essensys-hub/essensys-i2c-ba-sniffer/hardware/fritzing/export/sonde-i2c-passive-ensemble_breadboard.png

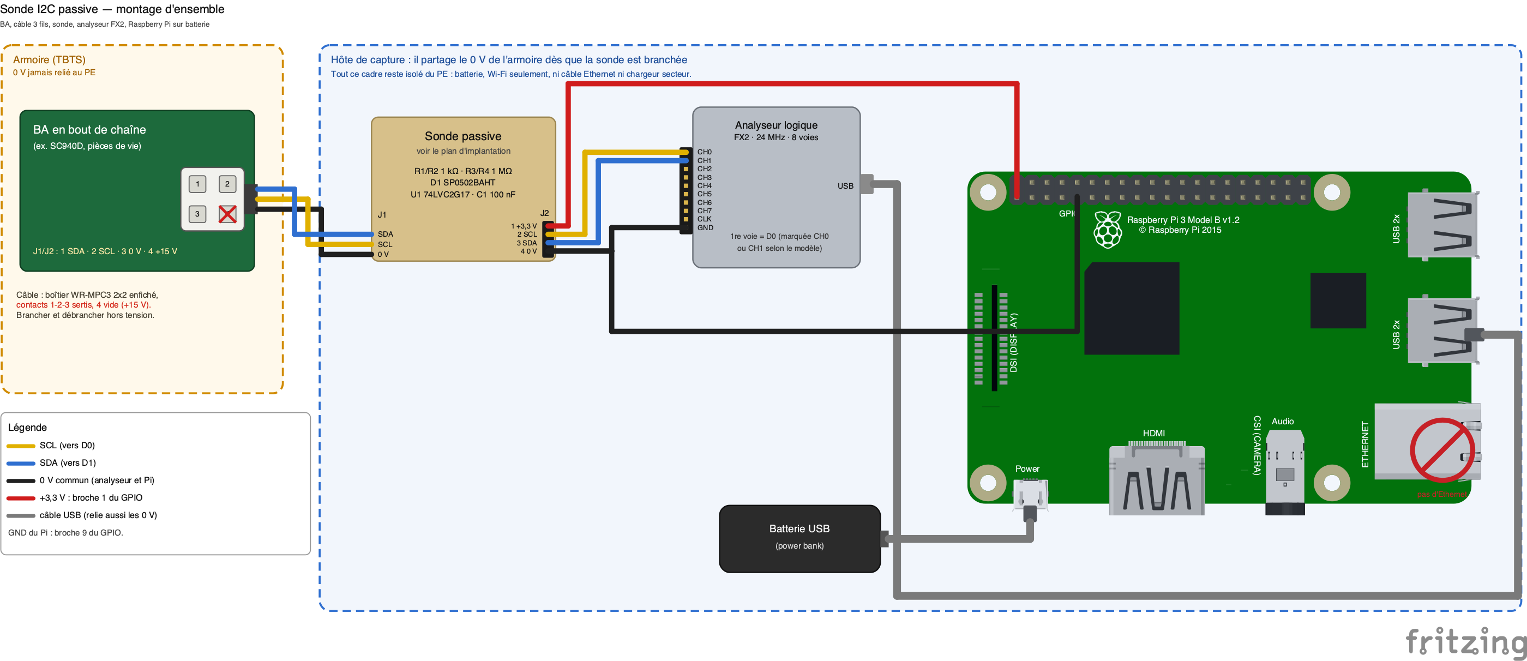
hardware/fritzing/export/sonde-i2c-passive-ensemble_breadboard.png
