essensys-hub/essensys-i2c-ba-sniffer/hardware/kicad/export/sonde-i2c-passive.png

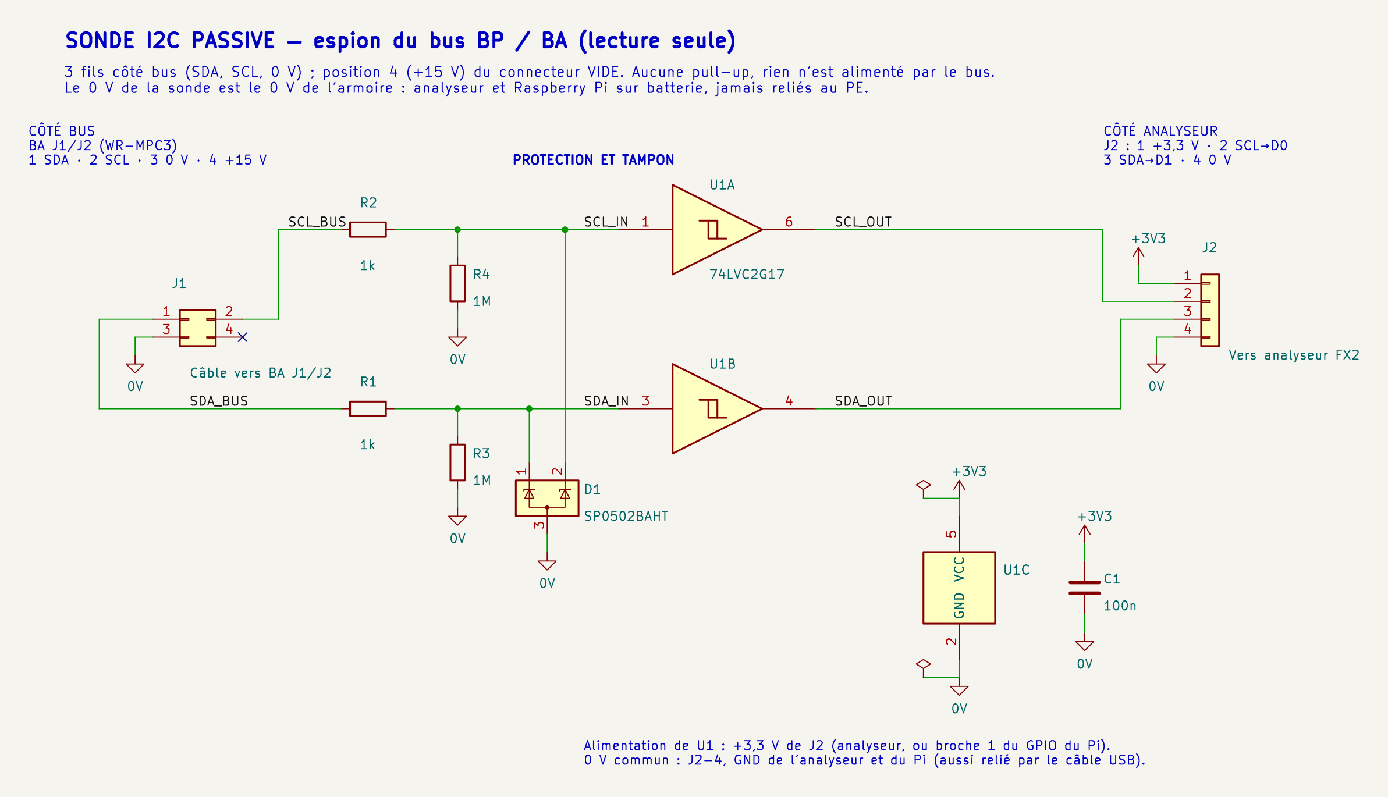
hardware/kicad/export/sonde-i2c-passive.png
