essensys-hub/essensys-i2c-ba-sniffer/hardware/kicad/export/sonde-i2c-passive-bom.csv

Repère | Valeur | Empreinte | Fabricant | Référence | Note | Qté
C1 | 100n | Capacitor_THT:C_Disc_D5.0mm_W2.5mm_P5.00mm |  |  | Découplage au plus près de U1 | 1
D1 | SP0502BAHT | Package_TO_SOT_SMD:SOT-23 | Littelfuse | SP0502BAHT | Sur adaptateur SOT-23 vers SIP3 | 1
J1 | Câble vers BA J1/J2 |  | Würth Elektronik | WR-MPC3 2x2, boîtier femelle câble (à confirmer, tâche 5.1) | Boîtier câble ; seuls les contacts 1, 2, 3 sont sertis, la position 4 (+15 V) reste vide ; fils soudés sur la plaque | 1
J2 | Vers analyseur FX2 | Connector_PinHeader_2.54mm:PinHeader_1x04_P2.54mm_Vertical |  |  | 1 +3,3 V, 2 SCL vers D0, 3 SDA vers D1, 4 0 V (GND de l'analyseur et du Pi) | 1
R1,R2 | 1k | Resistor_THT:R_Axial_DIN0207_L6.3mm_D2.5mm_P7.62mm_Horizontal |  |  | Série SCL,Série SDA | 2
R3,R4 | 1M | Resistor_THT:R_Axial_DIN0207_L6.3mm_D2.5mm_P7.62mm_Horizontal |  |  | Rappel SCL au 0 V,Rappel SDA au 0 V | 2
U1 | 74LVC2G17 | Package_TO_SOT_SMD:SOT-363_SC-70-6 | Nexperia / TI | 74LVC2G17GW / SN74LVC2G17DCK | Entrées tolérantes 5,5 V (Ioff) sous VCC = 3,3 V ; sur adaptateur SC-70 vers DIP6 | 1
