essensys-hub/essensys-i2c-ba-sniffer/hardware/mecanique/boitier-j1-wr-mpc3-assemblage.step

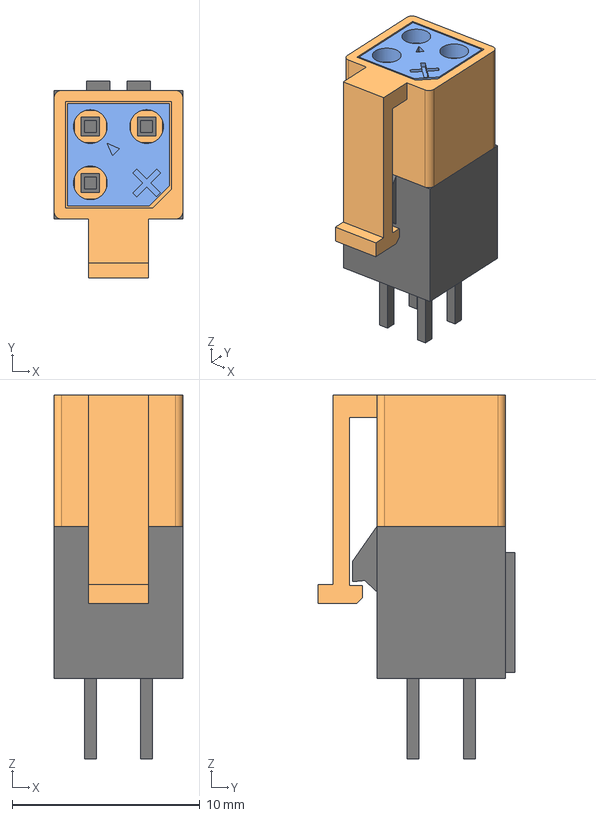
[picture p5: CAD file, 2026-10-14]
hardware/mecanique/boitier-j1-wr-mpc3-assemblage.step
6.86 x 10.5 x 19.4 mm
embase-BA-simplifiee
boitier
capot
