essensys-hub/essensys-i2c-ba-sniffer/hardware/mecanique/boitier-j1-wr-mpc3.step

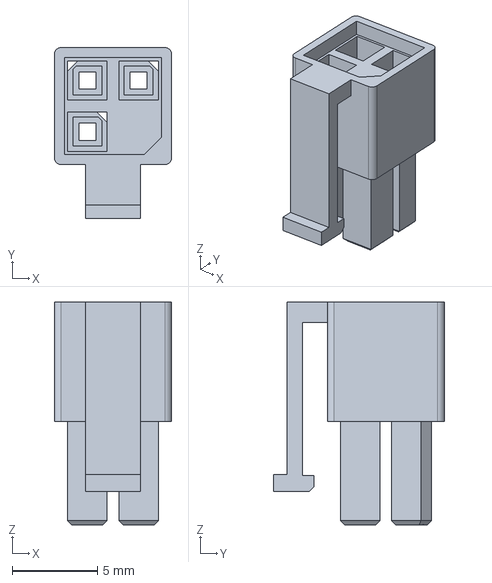
[picture p6: CAD file, 2026-10-14]
hardware/mecanique/boitier-j1-wr-mpc3.step
6.86 x 10.0 x 13.1 mm
