essensys-hub/essensys-i2c-ba-sniffer/hardware/mecanique/boitier-j1-wr-mpc3-capot.step

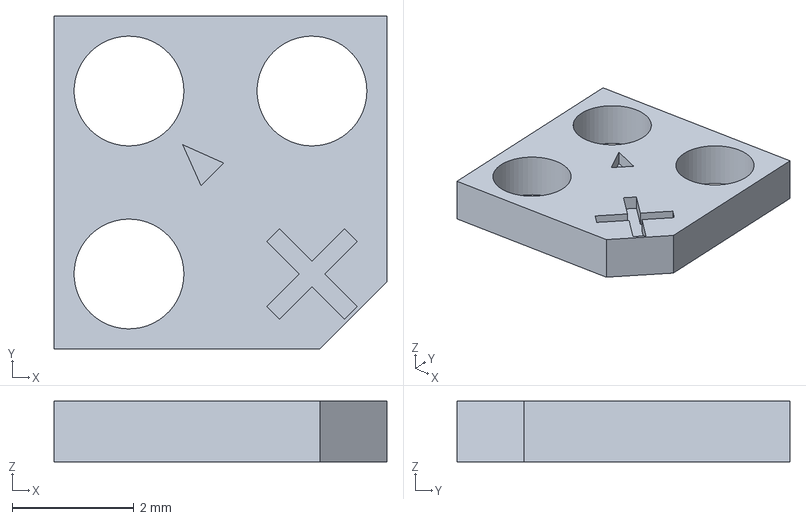
[picture p7: CAD file, 2026-10-14]
hardware/mecanique/boitier-j1-wr-mpc3-capot.step
5.46 x 5.46 x 1.00 mm
