essensys-hub/essensys-i2c-ba-sniffer/hardware/mecanique/calibre-contacts.step

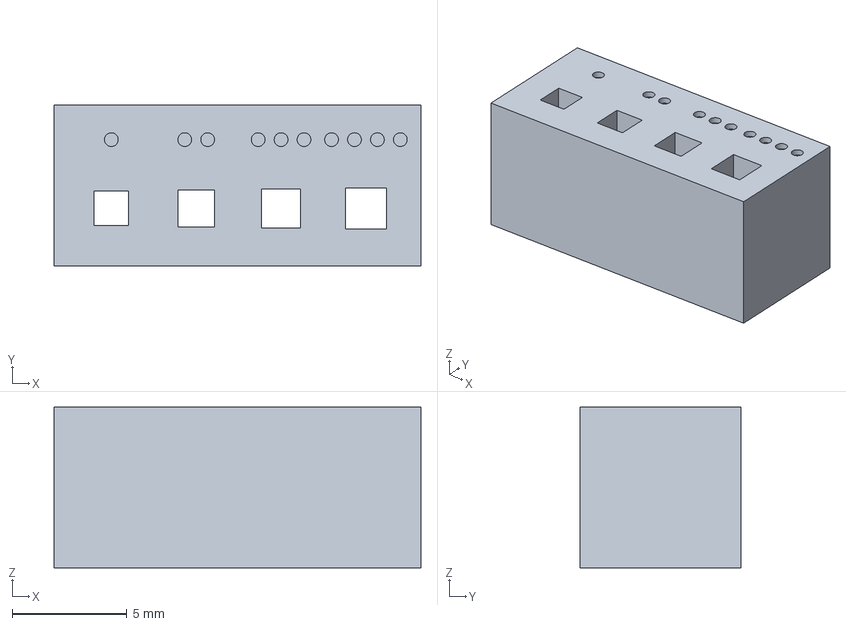
[picture p8: CAD file, 2026-10-14]
hardware/mecanique/calibre-contacts.step
16.0 x 7.00 x 7.00 mm
