essensys-hub/essensys-i2c-ba-sniffer/captures/corpus/cas_installation_2026_10.ann.txt

1005-1005 i2c-1: Start
1160-1180 i2c-1: Write
1020-1160 i2c-1: Address write: 11
1180-1200 i2c-1: ACK
1200-1360 i2c-1: Data write: 01
1360-1380 i2c-1: ACK
1380-1540 i2c-1: Data write: 00
1540-1560 i2c-1: ACK
1560-1720 i2c-1: Data write: 01
1720-1740 i2c-1: ACK
1740-1900 i2c-1: Data write: 00
1900-1920 i2c-1: ACK
1920-2080 i2c-1: Data write: 00
2080-2100 i2c-1: ACK
2100-2260 i2c-1: Data write: 00
2260-2280 i2c-1: ACK
2280-2440 i2c-1: Data write: 00
2440-2460 i2c-1: ACK
2460-2620 i2c-1: Data write: 00
2620-2640 i2c-1: ACK
2640-2800 i2c-1: Data write: 00
2800-2820 i2c-1: ACK
2820-2980 i2c-1: Data write: 17
2980-3000 i2c-1: ACK
3000-3160 i2c-1: Data write: A0
3160-3180 i2c-1: ACK
3185-3185 i2c-1: Start repeat
3340-3360 i2c-1: Read
3200-3340 i2c-1: Address read: 11
3360-3380 i2c-1: ACK
3380-3540 i2c-1: Data read: 01
3540-3560 i2c-1: ACK
3560-3720 i2c-1: Data read: 17
3720-3740 i2c-1: ACK
3740-3900 i2c-1: Data read: A0
3900-3920 i2c-1: ACK
3920-4080 i2c-1: Data read: 2F
4080-4100 i2c-1: ACK
4100-4260 i2c-1: Data read: 88
4260-4280 i2c-1: NACK
4285-4285 i2c-1: Stop
104295-104295 i2c-1: Start
104450-104470 i2c-1: Write
104310-104450 i2c-1: Address write: 12
104470-104490 i2c-1: NACK
104495-104495 i2c-1: Stop
204505-204505 i2c-1: Start
204660-204680 i2c-1: Write
204520-204660 i2c-1: Address write: 13
204680-204700 i2c-1: NACK
204705-204705 i2c-1: Stop
