essensys-hub/essensys-i2c-ba-sniffer/hardware/kicad/export/sonde-i2c-passive-schema.pdf

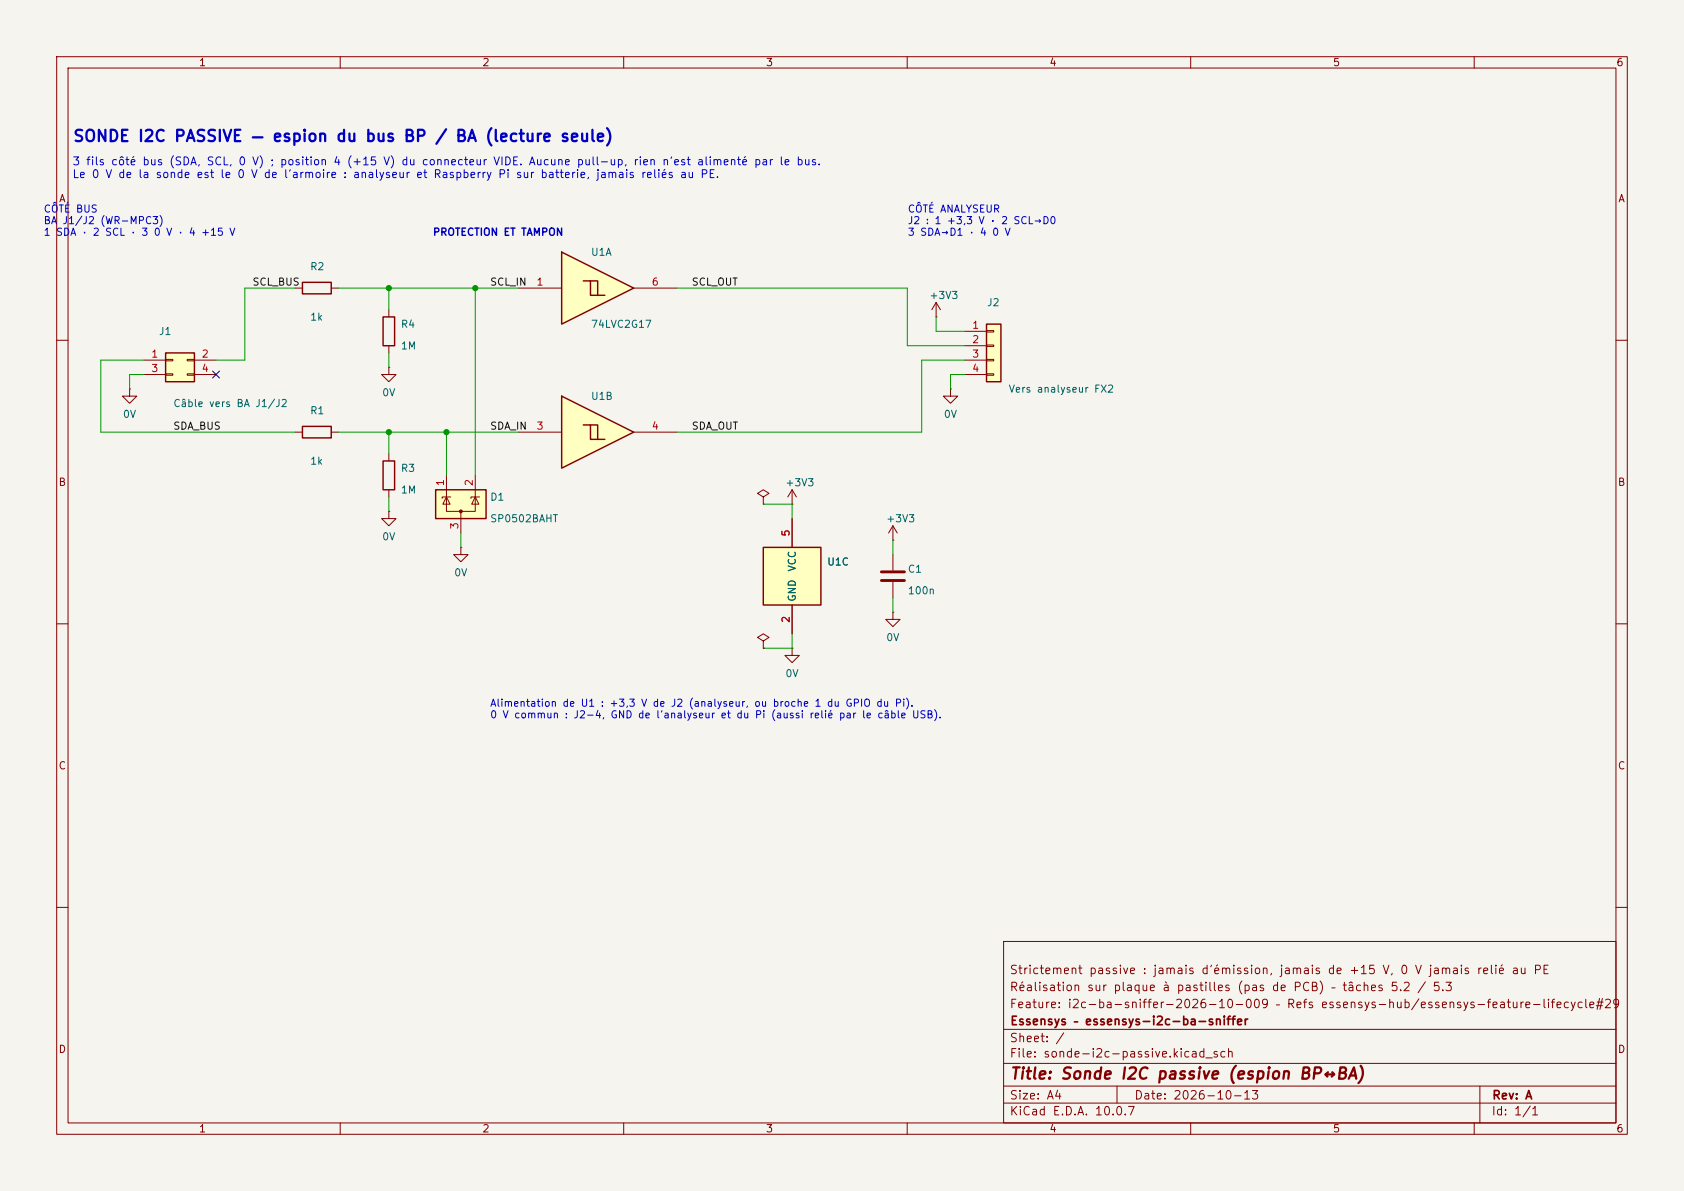
[picture p9: page 1]

SONDE I2C PASSIVE — espion du bus BP / BA (lecture seule)

3 fils côté bus (SDA, SCL, 0 V) ; position 4 (+15 V) du connecteur VIDE. Aucune pull-up, rien n'est alimenté par le bus. Le 0 V de la sonde est le 0 V de l'armoire : analyseur et Raspberry Pi sur batterie, jamais reliés au PE. PROTECTION ET TAMPON

SDA_BUS CÔTÉ BUS BA J1/J2 (WR-MPC3) 1 SDA · 2 SCL · 3 0 V · 4 +15 V

Alimentation de U1 : +3,3 V de J2 (analyseur, ou broche 1 du GPIO du Pi). 0 V commun : J2-4, GND de l'analyseur et du Pi (aussi relié par le câble USB).

Strictement passive : jamais d'émission, jamais de +15 V, 0 V jamais relié au PE
Réalisation sur plaque à pastilles (pas de PCB) – tâches 5.2 / 5.3
Feature: i2c-ba-sniffer-2026-10-009 – Refs essensys-hub/essensys-feature-lifecycle#29
Essensys – essensys-i2c-ba-sniffer
Sheet: /
File: sonde-i2c-passive.kicad_sch
Title: Sonde I2C passive (espion BP↔BA)

Size: A4 | Rev: A
KiCad E.D.A. 10.0.7 | Id: 1/1
