essensys-hub/essensys-i2c-ba-sniffer/(list of files, drawings)

Other design files:
hardware/fritzing/sonde-i2c-passive-ensemble.fzz
hardware/fritzing/sonde-i2c-passive-implantation.fzz
