essensys-hub/essensys-i2c-ba-sniffer/hardware/kicad/sonde-i2c-passive.kicad_sch

## KiCad design hardware/kicad/sonde-i2c-passive.kicad_sch (2026-10-13)

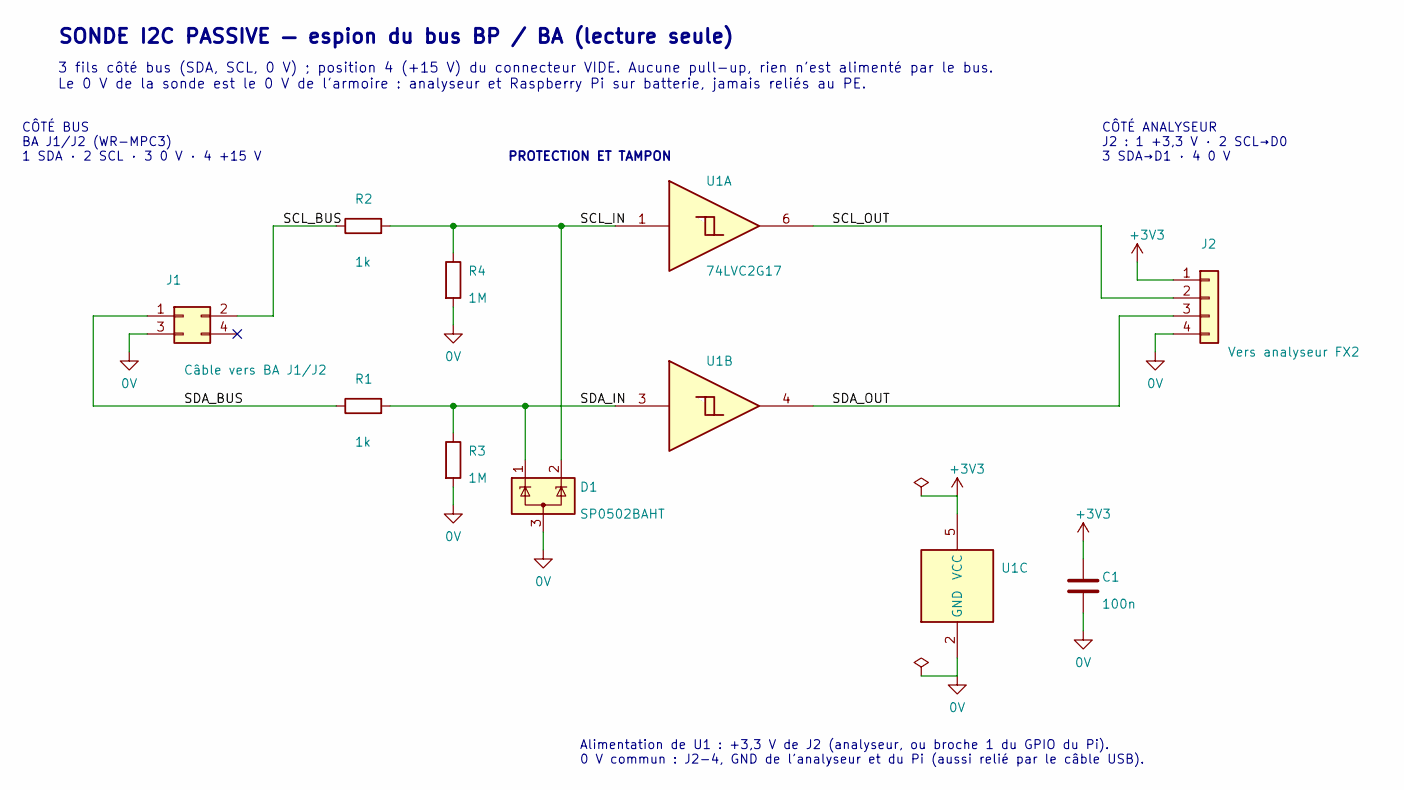
[picture p10: schematic sonde-i2c-passive.kicad_sch]

Parts:
C1: 100n; C_Disc_D5.0mm_W2.5mm_P5.00mm
D1: SP0502BAHT; SOT-23; MPN SP0502BAHT
J1: Câble vers BA J1/J2; MPN WR-MPC3 2x2, boîtier femelle câble (à c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
J2: Vers analyseur FX2; PinHeader_1x04_P2.54mm_Vertical
R1, R2: 1k; R_Axial_DIN0207_L6.3mm_D2.5mm_P7.62mm_Horizontal
R3, R4: 1M; R_Axial_DIN0207_L6.3mm_D2.5mm_P7.62mm_Horizontal
U1: 74LVC2G17; SOT-363_SC-70-6; MPN 74LVC2G17GW / SN74LVC2G17DCK

Connections:
0V: C1.2, D1.3 (A), J1.3, J2.4, R3.2, R4.2, U1.2 (GND)
+3V3: C1.1, J2.1, U1.5 (VCC)
SCL_BUS: J1.2, R2.1
SCL_IN: D1.2 (K), R2.2, R4.1, U1.1
SCL_OUT: J2.2, U1.6
SDA_BUS: J1.1, R1.1
SDA_IN: D1.1 (K), R1.2, R3.1, U1.3
SDA_OUT: J2.3, U1.4

Notes on the sheet:
SONDE I2C PASSIVE — espion du bus BP / BA (lecture seule)
3 fils côté bus (SDA, SCL, 0 V) ; position 4 (+15 V) du connecteur VIDE. Aucune pull-up, rien n'est alimenté par le bus. Le 0 V de la sonde est le 0 V de l'armoire : analyseur et Raspberry Pi sur batterie, jamais reliés au PE.
CÔTÉ BUS BA J1/J2 (WR-MPC3) 1 SDA · 2 SCL · 3 0 V · 4 +15 V
PROTECTION ET TAMPON
CÔTÉ ANALYSEUR J2 : 1 +3,3 V · 2 SCL→D0 3 SDA→D1 · 4 0 V
Alimentation de U1 : +3,3 V de J2 (analyseur, ou broche 1 du GPIO du Pi). 0 V commun : J2-4, GND de l'analyseur et du Pi (aussi relié par le câble USB).
