essensys-hub/essensys-i2c-ba-sniffer/(commit log)

2026-10-13 docs(openspec): change i2c-ba-sniffer-2026-10-009 — espion I2C passif sigrok + décodeur Python (essensys-hub/essensys-feature-lifecycle#29)
    - proposal, design, 6 capacités (sigrok-capture, i2c-frame-decode,
    ba-event-semantics, debug-tooling, sniffer-probe-hardware,
    debug-documentation), tasks en 8 groupes ;
    - reprise des specs de décodage du change essensys-i2c-ba-sniffer-2026-07-038
    (Pico = phase 2), corrigées sur le code : CRC-16/MODBUS confirmé dans crc.c,
    profils de sorties par type de BA relevés dans hard.c ;
    - manifeste features/i2c-ba-sniffer-2026-10-009.json (gate --strict OK) ;
    - openspec/config.yaml et README.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
2026-10-13 docs(openspec): numéros des sous-issues dans tasks.md (essensys-hub/essensys-feature-lifecycle#29)
2026-10-13 feat(decoder): espion I2C passif — décodeur Python, corpus et CI (essensys-hub/essensys-feature-lifecycle#29)
    Groupes 1 à 4 du change i2c-ba-sniffer-2026-10-009 (sous-issues #1 à #4) :
    - paquet essensys_i2c_sniffer (Python ≥ 3.11, sans dépendance) et CLI
    essensys-i2c-sniff : live (fx2lafw, ≥ 1 MHz), replay (.sr/.bin/.bin.gz),
    annotations, correlate ;
    - flux brut unique partagé entre le décodeur I2C de sigrok (oracle) et la
    détection des lignes bloquées, fusion par numéro d'échantillon : rejeu
    identique au direct ;
    - transactions, identité des BA (0x11/0x12/0x13), longueur par code de trame,
    CRC-16/MODBUS, écho de réponse (00 00 si CRC rejeté), répétitions et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
2026-10-13 ci: conteneur KiCad en root pour actions/checkout ; hardware/README (connecteur J1/J2 Micro Mate-N-Lok 2x2) (essensys-hub/essensys-i2c-ba-sniffer#1)
2026-10-13 docs(openspec): tâche 1.2 cochée — CI verte (essensys-hub/essensys-i2c-ba-sniffer#1)
2026-10-13 feat(hardware): sonde passive — schéma KiCad, câblage Fritzing, plaque à pastilles (essensys-hub/essensys-i2c-ba-sniffer#5)
    Tâches 5.2 à 5.4 du change i2c-ba-sniffer-2026-10-009 :
    - schéma KiCad 9 généré (hardware/kicad/gen_sch.py) : J1 WR-MPC3 2x2 position 4
    vide, R1/R2 1 kΩ série, R3/R4 1 MΩ, D1 SP0502BAHT, U1 74LVC2G17 en 3,3 V,
    C1, J2 vers l'analyseur ; ERC 0 erreur 0 avertissement ; exports PDF, SVG,
    PNG et nomenclature ;
    - décision 5.3 : plaque à pastilles (adaptateurs SOT-23 et SC-70), pas de PCB ;
    - câblage Fritzing généré (hardware/fritzing/gen_fzz.py) BA → sonde → FX2 →
    Raspberry Pi sur batterie, fils placés sur les connecteurs lus dans les SVG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
    [sonde-i2c-passive-bom.csv, sonde-i2c-passive.fzz, sonde-i2c-passive.kicad_sch]
2026-10-13 ci: ERC de la sonde avec KiCad 10 (symboles embarqués depuis la bibliothèque KiCad 10) (essensys-hub/essensys-i2c-ba-sniffer#5)
2026-10-13 docs(openspec): tâches 7.1 à 7.4 cochées — section docs/debug (essensys-hub/essensys-doc#10)
2026-10-13 docs(openspec): tâche 8.1 cochée — wiki essensys-memory (essensys-hub/essensys-memory#17)
2026-10-13 ci: synchronisation du Project #6 sur les événements de PR (essensys-hub/essensys-feature-lifecycle#29)
    Appelle le workflow réutilisable essensys-feature-lifecycle/project-sync.yml :
    - PR ouverte, rouverte ou sortie du brouillon → pr-opened ;
    - PR fusionnée → all-prs-merged.
    Le Feature ID est lu dans le corps de la PR. Sans PROJECT_SYNC_TOKEN, la
    synchronisation est ignorée avec un avertissement (la CI ne casse pas).
    actionlint OK.
2026-10-13 docs(openspec): tâche 7.5 cochée — docs/debug publiée sur www.essensys.fr (essensys-hub/essensys-doc#10)
2026-10-13 fix(hardware): schémas de la sonde corrigés après relecture critique (essensys-hub/essensys-i2c-ba-sniffer#5)
    KiCad :
    - schéma câblé de gauche à droite (SCL en haut, SDA en bas) au lieu d'étiquettes
    partout ; symboles 0 V / +3V3 locaux ; J1 sans empreinte trompeuse (câble) ;
    - J2 réordonné : 1 +3,3 V, 2 SCL (D0), 3 SDA (D1), 4 0 V (pas de croisement) ;
    - check_netlist.py : la netlist exportée doit correspondre au circuit voulu
    (lancé en CI après l'ERC) ; export PNG recadré sur le contenu.
    Fritzing (deux croquis, pièces embarquées dessinées par le générateur) :
    - implantation sur plaque à pastilles : repères et valeurs lisibles, vrai
    connecteur 2x2 avec la positio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
    [sonde-i2c-passive-bom.csv, sonde-i2c-passive-ensemble.fzz, sonde-i2c-passive-implantation.fzz, sonde-i2c-passive.fzz, sonde-i2c-passive.kicad_sch]
2026-10-13 feat(hardware): boîtier J1 imprimable pour l'embase WR-MPC3 des BA (essensys-hub/essensys-i2c-ba-sniffer#5)
    Boîtier enfichable à imprimer en résine, pour l'embase J1/J2 des BA
    (Würth 66200421122), avec trois contacts seulement : 1 SDA, 2 SCL, 3 0 V.
    - position 4 (+15 V) borgne : la broche entre, aucun logement au-dessus,
    capot plein à cet endroit, croix gravée ;
    - tours détrompées (coin abattu de chaque logement), verrou souple
    accroché sur la rampe de l'embase ;
    - cotes de l'embase relevées sur le modèle 3D de la carte SC940D ; brochage
    lu dans SI940D.PcbDoc (3 = GNDBUS sous la 1, 4 = +VBUS en diagonale) ;
    - gen_boitier_j1.py (CadQuery) : contrôles d'interférence avec l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
    [boitier-j1-wr-mpc3-assemblage.step, boitier-j1-wr-mpc3-capot.step, boitier-j1-wr-mpc3.step, calibre-contacts.step]
